cHemingway/turbo_fan_remote/turbo_fan_remote.pdf

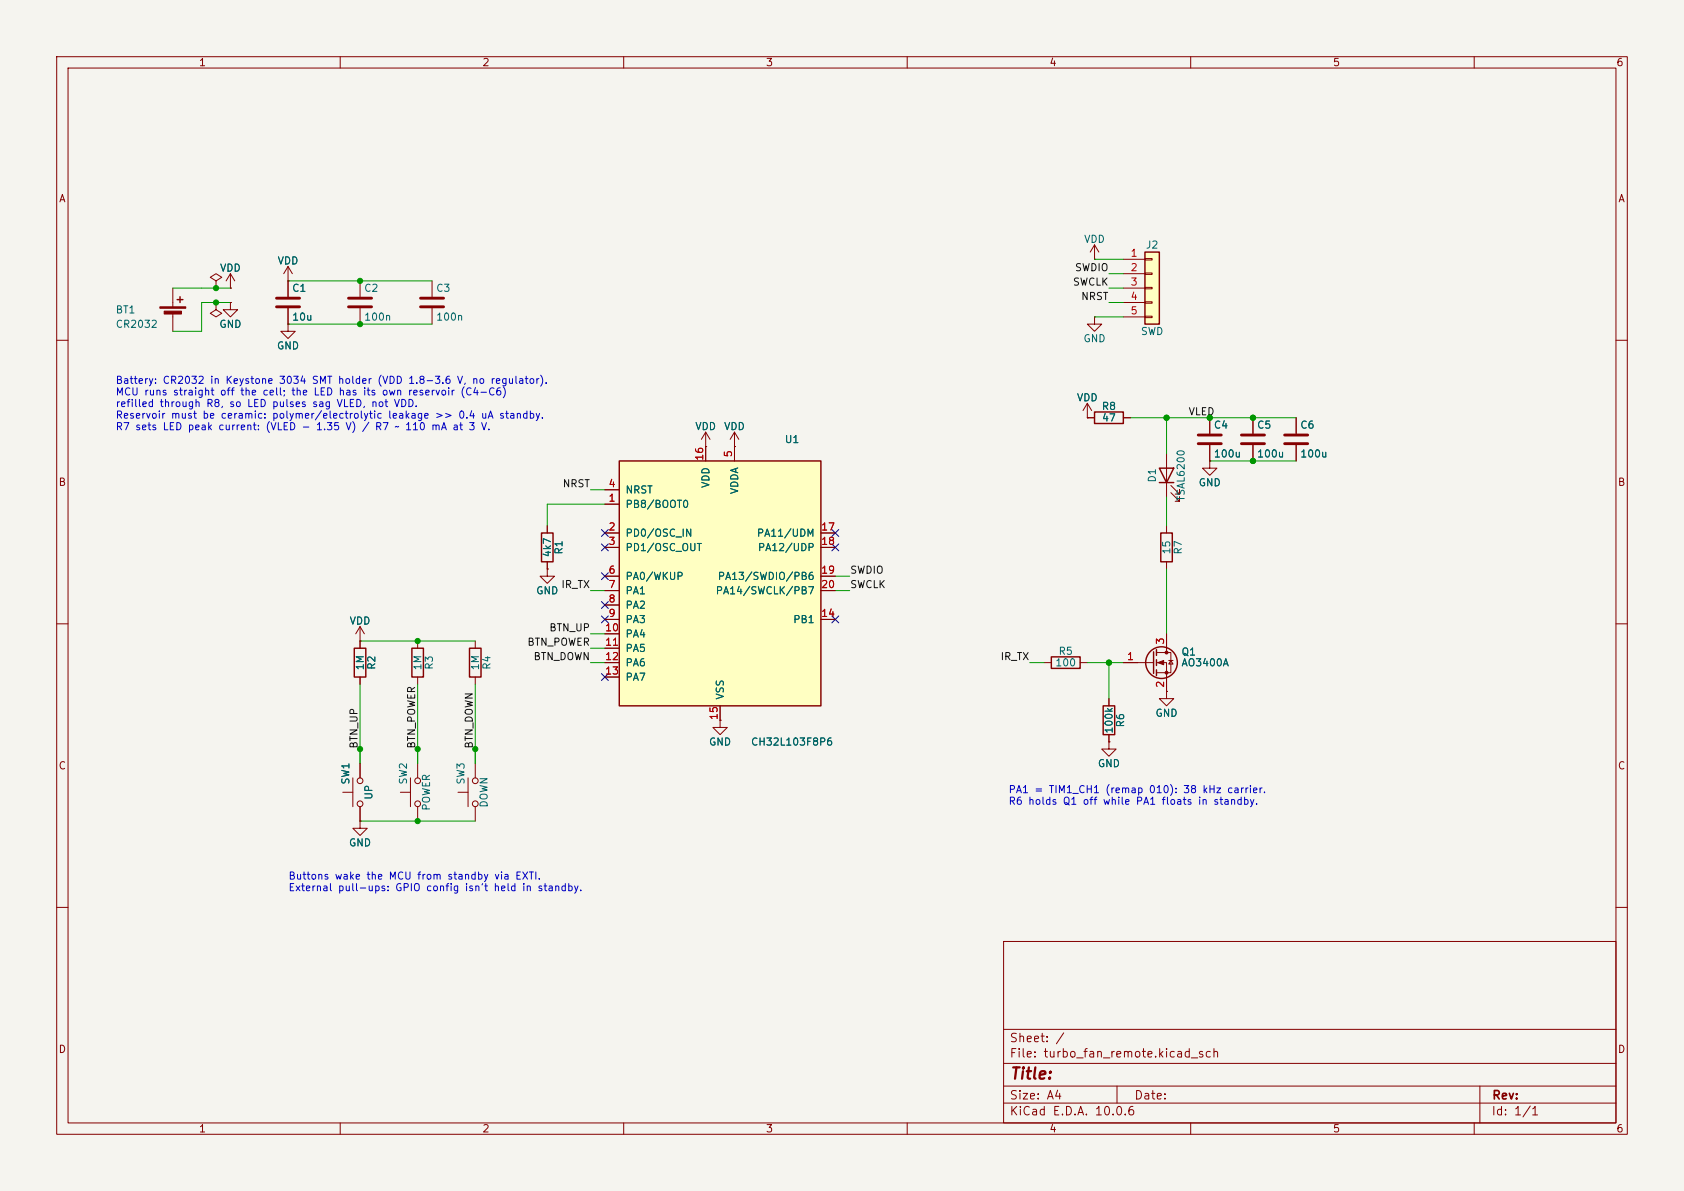
[picture p8: page 1]

Battery: CR2032 in Keystone 3034 SMT holder (VDD 1.8-3.6 V, no regulator). MCU runs straight off the cell; the LED has its own reservoir (C4-C6)

Size: A4 | Rev:
KiCad E.D.A. 10.0.6 | Id: 1/1
