cHemingway/turbo_fan_remote/turbo_fan_remote.kicad_sch

## KiCad design turbo_fan_remote.kicad_sch (2026-10-10)

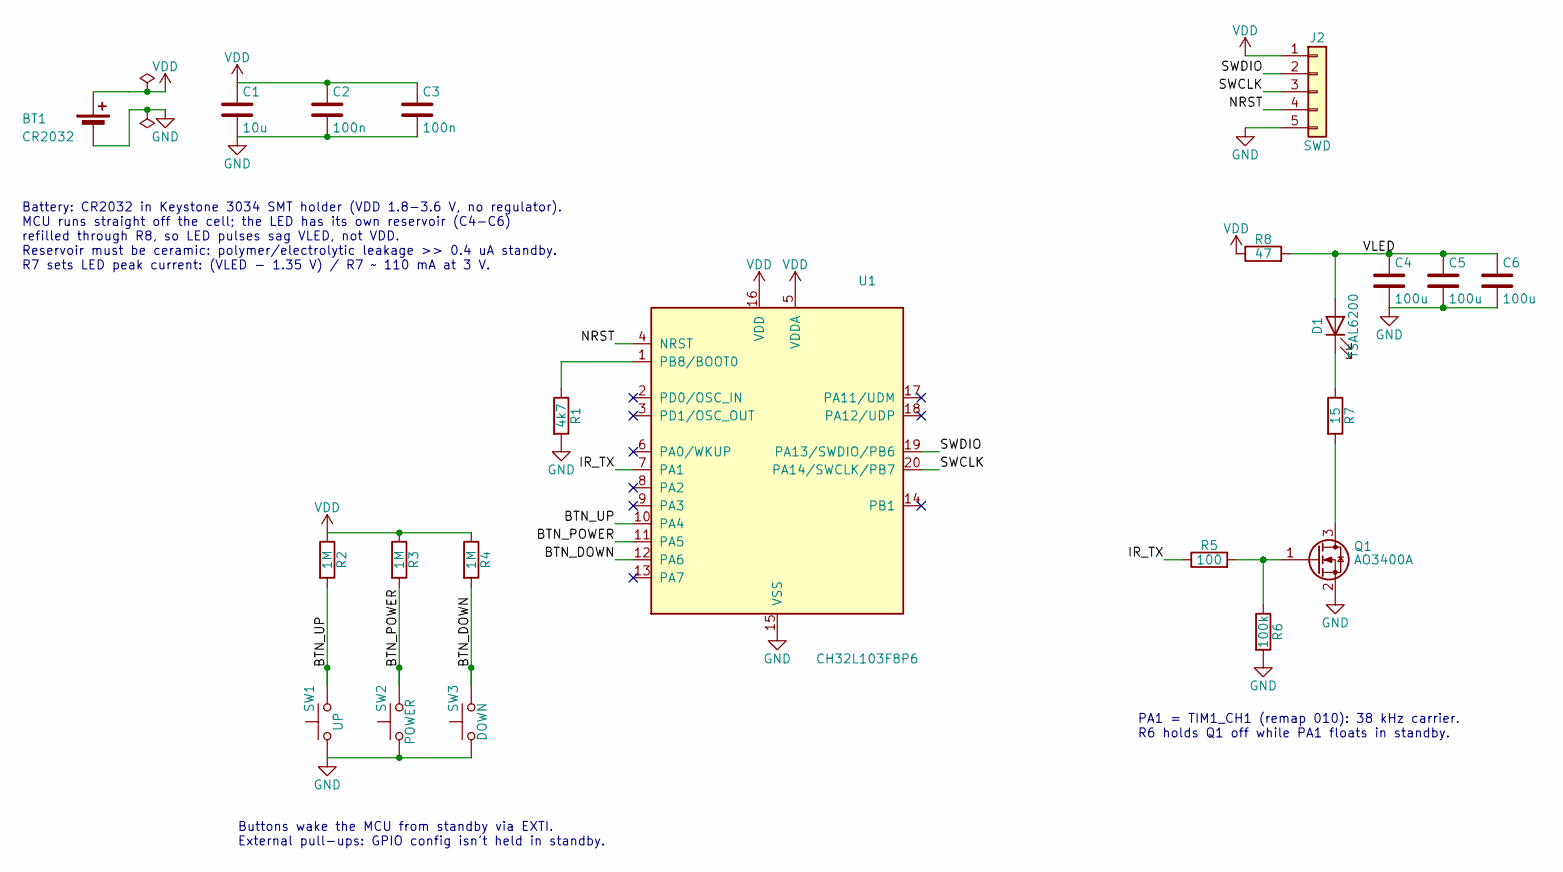
[picture p9: schematic turbo_fan_remote.kicad_sch]

Parts:
BT1: CR2032; BatteryHolder_Keystone_3034_1x20mm; MPN 3034TR; LCSC C5213768
C1: 10u; C_0805_2012Metric; MPN CL21A106KAYNNNE; LCSC C15850
C2, C3: 100n; C_0402_1005Metric; MPN CL05B104KO5NNNC; LCSC C1525
C4, C5, C6: 100u; C_1206_3216Metric; MPN CL31A107MQHNNNE; LCSC C15008
D1: TSAL6200; LED_D5.0mm_IRGrey; MPN TSAL6200; LCSC C55528
J2: SWD; PinHeader_1x05_P2.54mm_Vertical
Q1: AO3400A; SOT-23; MPN AO3400A; LCSC C20917
R1: 4k7; R_0402_1005Metric; MPN 0402WGF4701TCE; LCSC C25900
R2, R3, R4: 1M; R_0402_1005Metric; MPN 0402WGF1004TCE; LCSC C26083
R5: 100; R_0402_1005Metric; MPN 0402WGF1000TCE; LCSC C25076
R6: 100k; R_0402_1005Metric; MPN 0402WGF1003TCE; LCSC C25741
R7: 15; R_0805_2012Metric; MPN 0805W8F150JT5E; LCSC C17480
R8: 47; R_0402_1005Metric; MPN 0402WGF470JTCE; LCSC C25118
SW1: UP; SW_SPST_PTS645Sx43SMTR92; MPN PTS645SK43SMTR92 LFS; LCSC C221871
SW2: POWER; SW_SPST_PTS645Sx43SMTR92; MPN PTS645SK43SMTR92 LFS; LCSC C221871
SW3: DOWN; SW_SPST_PTS645Sx43SMTR92; MPN PTS645SK43SMTR92 LFS; LCSC C221871
U1: CH32L103F8P6; TSSOP-20_4.4x6.5mm_P0.65mm; MPN CH32L103F8P6; LCSC C49258061

Connections:
BTN_DOWN: R4.2, SW3.2, U1.12 (PA6)
BTN_POWER: R3.2, SW2.2, U1.11 (PA5)
BTN_UP: R2.2, SW1.2, U1.10 (PA4)
GND: BT1.2 (-), C1.2, C2.2, C3.2, C4.2, C5.2, C6.2, J2.5, Q1.2 (S), R1.2, R6.2, SW1.1, SW2.1, SW3.1, U1.15 (VSS)
IR_TX: R5.1, U1.7 (PA1)
NRST: J2.4, U1.4 (NRST)
unnamed: D1.1 (K), R7.1
unnamed: Q1.1 (G), R5.2, R6.1
unnamed: Q1.3 (D), R7.2
unnamed: R1.1, U1.1 (PB8/BOOT0)
SWCLK: J2.3, U1.20 (PA14/SWCLK/PB7)
SWDIO: J2.2, U1.19 (PA13/SWDIO/PB6)
VDD: BT1.1 (+), C1.1, C2.1, C3.1, J2.1, R2.1, R3.1, R4.1, R8.1, U1.5 (VDDA), U1.16 (VDD)
VLED: C4.1, C5.1, C6.1, D1.2 (A), R8.2

Notes on the sheet:
Buttons wake the MCU from standby via EXTI. External pull-ups: GPIO config isn't held in standby.
PA1 = TIM1_CH1 (remap 010): 38 kHz carrier. R6 holds Q1 off while PA1 floats in standby.
Battery: CR2032 in Keystone 3034 SMT holder (VDD 1.8-3.6 V, no regulator). MCU runs straight off the cell; the LED has its own reservoir (C4-C6) refilled through R8, so LED pulses sag VLED, not VDD. Reservoir must be ceramic: polymer/electrolytic leakage >> 0.4 uA standby. R7 sets LED peak current: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
