cHemingway/turbo_fan_remote/(commit log)

2026-10-10 Initial turbo fan IR remote: firmware, schematic and battery calcs
    - fw/: CH32L103F8P6 firmware using ch32fun (git submodule). TIM1 makes
    the 38 kHz carrier, with the repetition counter and DMA burst stepping
    through NEC marks/spaces. Standby between presses with EXTI wake,
    capped repeat codes with stuck-button handling, and PVD brown-out
    checks before and during each frame.
    - KiCad project: CH32L103F8P6 (custom symbol), C&K PTS645 6x6 mm
    switches, TSAL6200 IR LED on an AO3400A low-side driver, LED fed from
    its own reservoir via R8, CR2032 in a Keystone 3034 SMT holder, SWD
    header. LCSC part numbers on all BOM parts except J2.
    - calcs/battery_life.py: marimo notebook (PEP 723 d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
    [turbo_fan_remote.kicad_pcb, turbo_fan_remote.kicad_sch]
2026-10-10 Raise brown-out abort to 2.08 V, add clangd setup, highlight expected life
    - fw/remote.c: PVD_LEVEL_ABORT now PLS_MODE2 (2.08 V falling) instead of
    1.87 V, giving ~0.28 V margin above the MCU's 1.8 V minimum for the
    untoleranced PVD thresholds. Costs ~2-3 mAh per the battery calcs.
    - fw/.clangd: point clangd at riscv32 and the toolchain's newlib headers
    so compile_commands.json from `make clangd` (bear) works with Apple
    clang. compile_commands.json and .cache/ are ignored.
    - calcs/battery_life.py: highlight the typical-leakage rows for the
    firmware's abort level (21 C and 0 C) in the results table.
    Claude-Session: https://cla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
    [remote.c]
2026-10-10 Battery calcs: add appendix with NEC timing and single-press trace
    Adds an NEC timing table (108 ms frame/repeat period, ~39.9 ms gap after
    the full frame, ~96.2 ms between repeats) and a time-domain plot of one
    press (frame + 3 repeats) at 0 C, halfway through usable life: IR
    envelope, VDD/VLED, and LED pulse current. Shows the 9 ms leader is the
    heaviest load on the LED reservoir while VDD stays well above the abort
    level.
    Claude-Session: https://claude.ai/code/session_01VhXXbNUtWKUMtPu2Dw13nN
2026-10-10 Battery calcs: add R7 analysis appendix and LED linearity note
    Appendix B derives the closed-form LED pulse current during a burst,
    shows both limits favour a smaller R7, that the optimum for a finite
    burst has no elementary closed form, and gives closed-form bounds:
    R_opt < R_crit (~11 Ohm) and R7 >= R_FM (~8.4 Ohm, 200 mA peak at a
    3.2 V fresh cell). Checked against the full simulation with an R7
    sweep of weakest pulse and battery life. R7 stays at 15 Ohm for now.
    Also notes that the TSAL6200 intensity vs current is near-linear up to
    ~1 A, so there's no saturation in the 40-170 mA operating range.
    Claude-Session: https://claude.ai/c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
2026-10-11 Update Makefile to include PDF generation for battery life calcs and schematic
